dev-repos/printed-wheelbarrow-walker/README.md

# Printed Wheelbarrow Walker

**Site with the assembly video and a 3D part viewer: https://dev-repos.github.io/printed-wheelbarrow-walker/**

A small walking robot that pushes a wheelbarrow, driven by one TT gear motor. Two complete builds from one design:

- **Full 3D print**: 11 parts in [`stl/`](stl/), no supports, every part fits a 180 × 180 mm bed. Settings and fits: [`print.md`](print.md).
- **Full cardboard**: the same parts cut from 3 mm corrugated card. Print [`cardboard/templates.pdf`](cardboard/templates.pdf) at **100 % / actual size** (check the 100 mm bar).

Bought for both: a TT gear motor (double shaft, 3–6 V), a 2×AA battery holder with switch, a 3 mm skewer, a ping-pong ball and a bottle cap. The motor and holder attach without glue (see `print.md`).

| Full 3D print | Full cardboard |
|---|---|
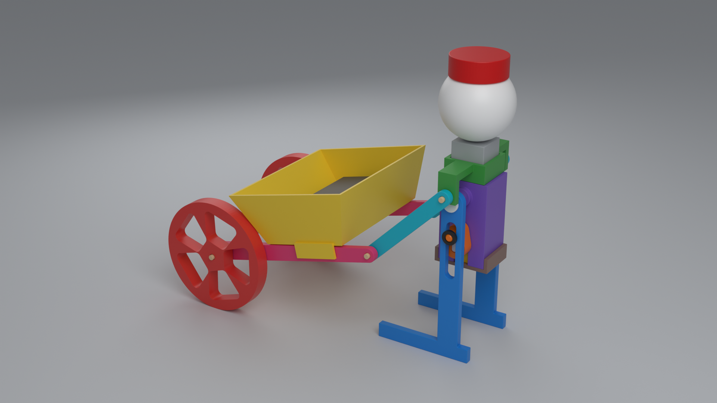
[picture p1: renders/assembled-printed.png]
printed
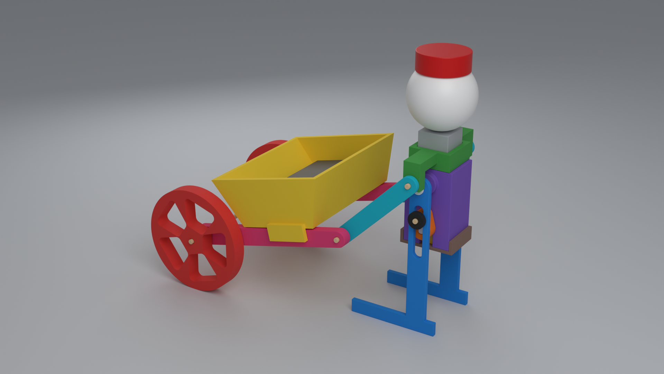
[picture p2: renders/assembled-cardboard.png]
cardboard
|  |  |

Building with kids: a grown-up does knife cuts, hot glue and soldering. Small parts (pegs, caps) are a choking hazard for under-3s.

Mechanism: pendulum legs driven by cranks 180° apart (8 mm crank, hip 26 mm above the shaft). Stride 54.2 mm, foot lift 4.3 mm, checked for clashes at 8 crank angles.

License: MIT.

## Assembly preview

**Assembly video (60 s, with voice-over):** [preview/assembly-sample.mp4](preview/assembly-sample.mp4). A claw gripper pushes the motor into the cradle can first, snaps the clip on, fits the crank, then the leg, hip peg and cap (legs go on before the yoke). Then the battery holder drops into the tray between the ribs, its red and black wires run to the motor tabs, and the switch goes on, so it walks. Each move happens while the voice-over describes it, and every move (and every wire, at every crank angle) is checked so nothing passes through anything else.

Workbench renders of the first build steps (lift → align → fit → check). A two-jaw claw holds each part at the point where you'd grip it.

| Kit | Motor into cradle | Crank onto shaft | Hang a leg |
|---|---|---|---|
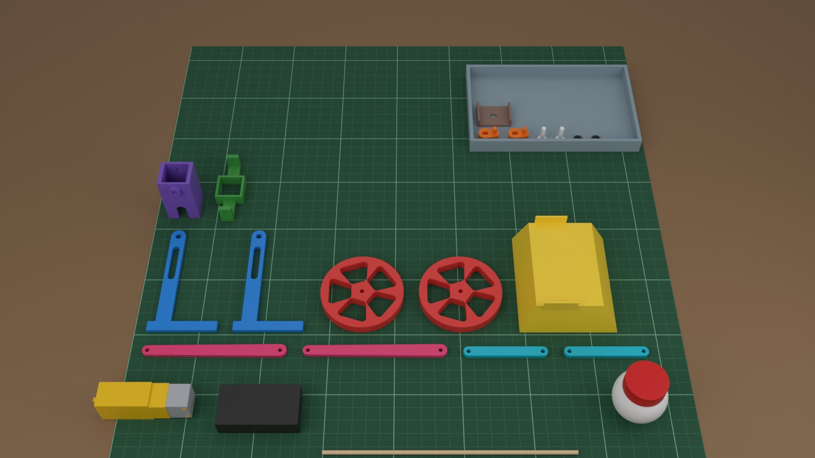
[picture p3: preview/01-kit.jpg]
kit
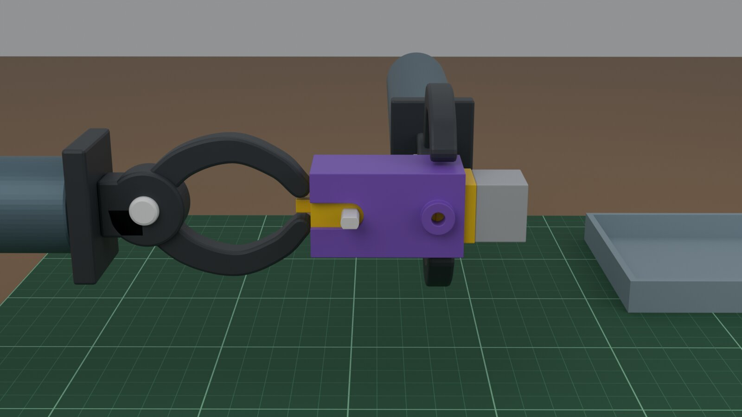
[picture p4: preview/02-motor-3-seated.jpg]
motor
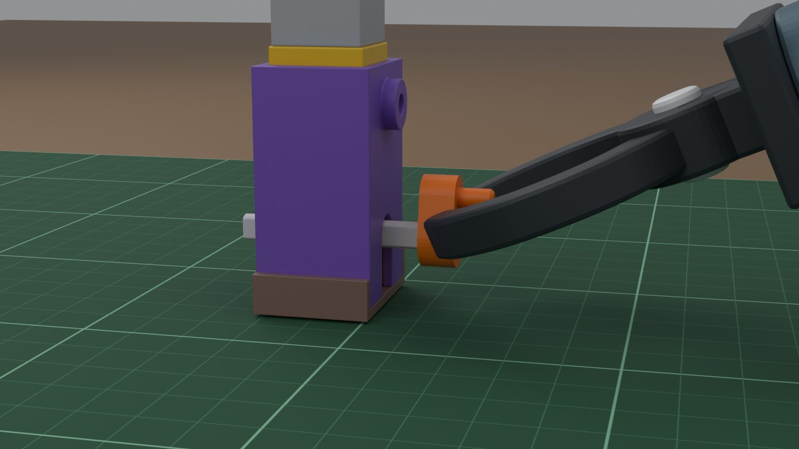
[picture p5: preview/03-crank-2-push.jpg]
crank
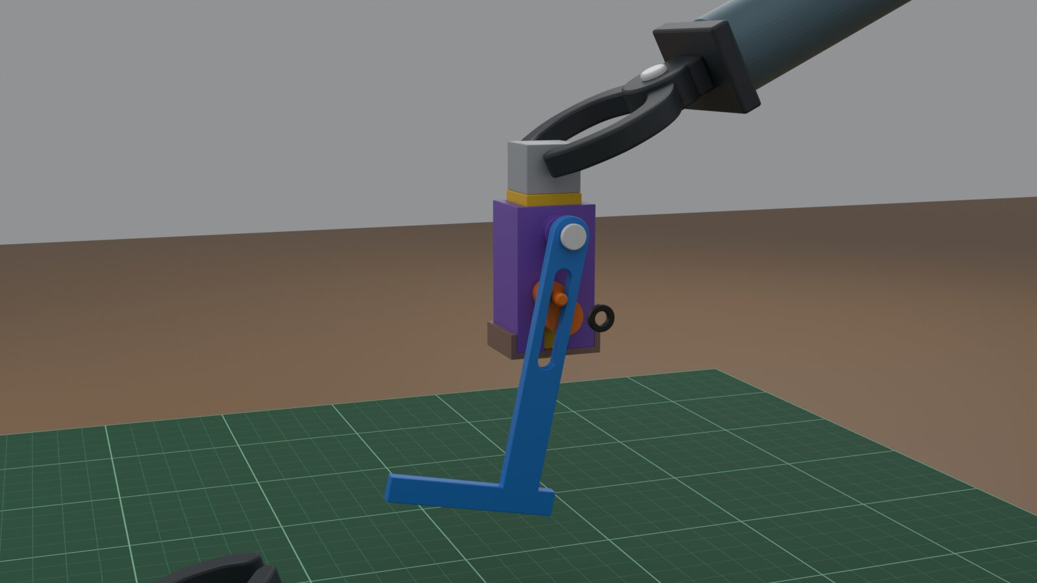
[picture p6: preview/04-leg-3-peg.jpg]
leg
|  |  |  |  |

| Battery holder in the tray | Wires to the motor tabs | Switch on |
|---|---|---|
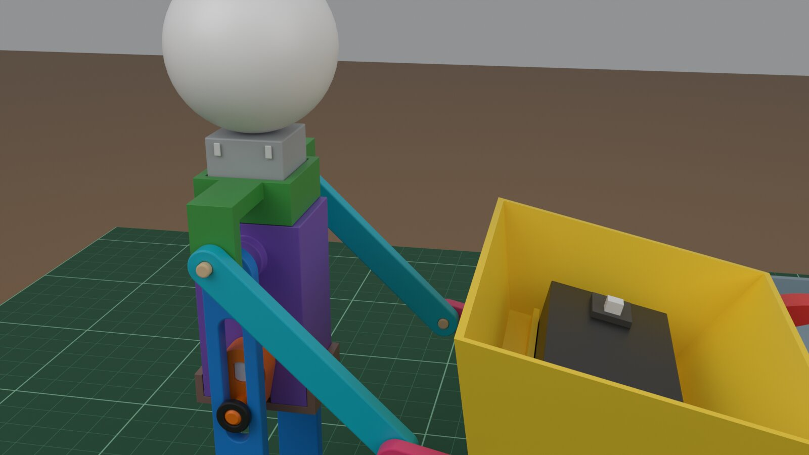
[picture p7: preview/05-power-2-holder.jpg]
holder
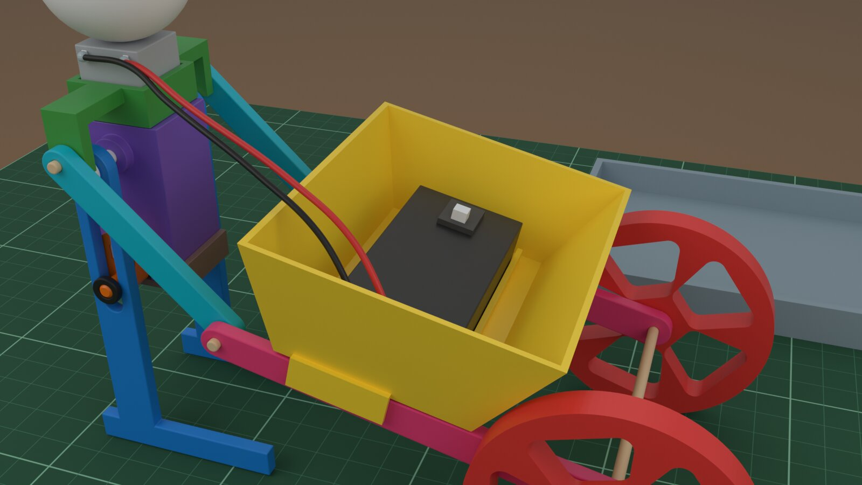
[picture p8: preview/05-power-3-wires.jpg]
wires
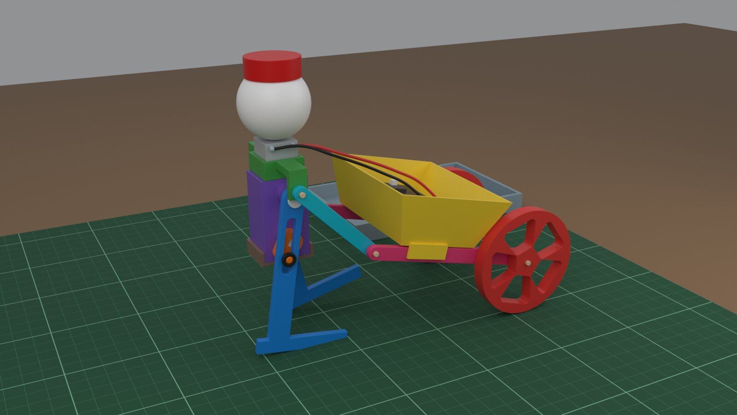
[picture p9: preview/05-power-4-on.jpg]
on
|  |  |  |

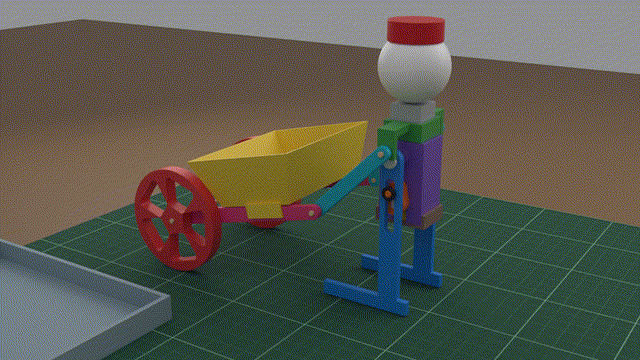
[picture p10: preview/walk.gif]
walking
