dev-repos/printed-wheelbarrow-walker/cardboard/sheet-1.png

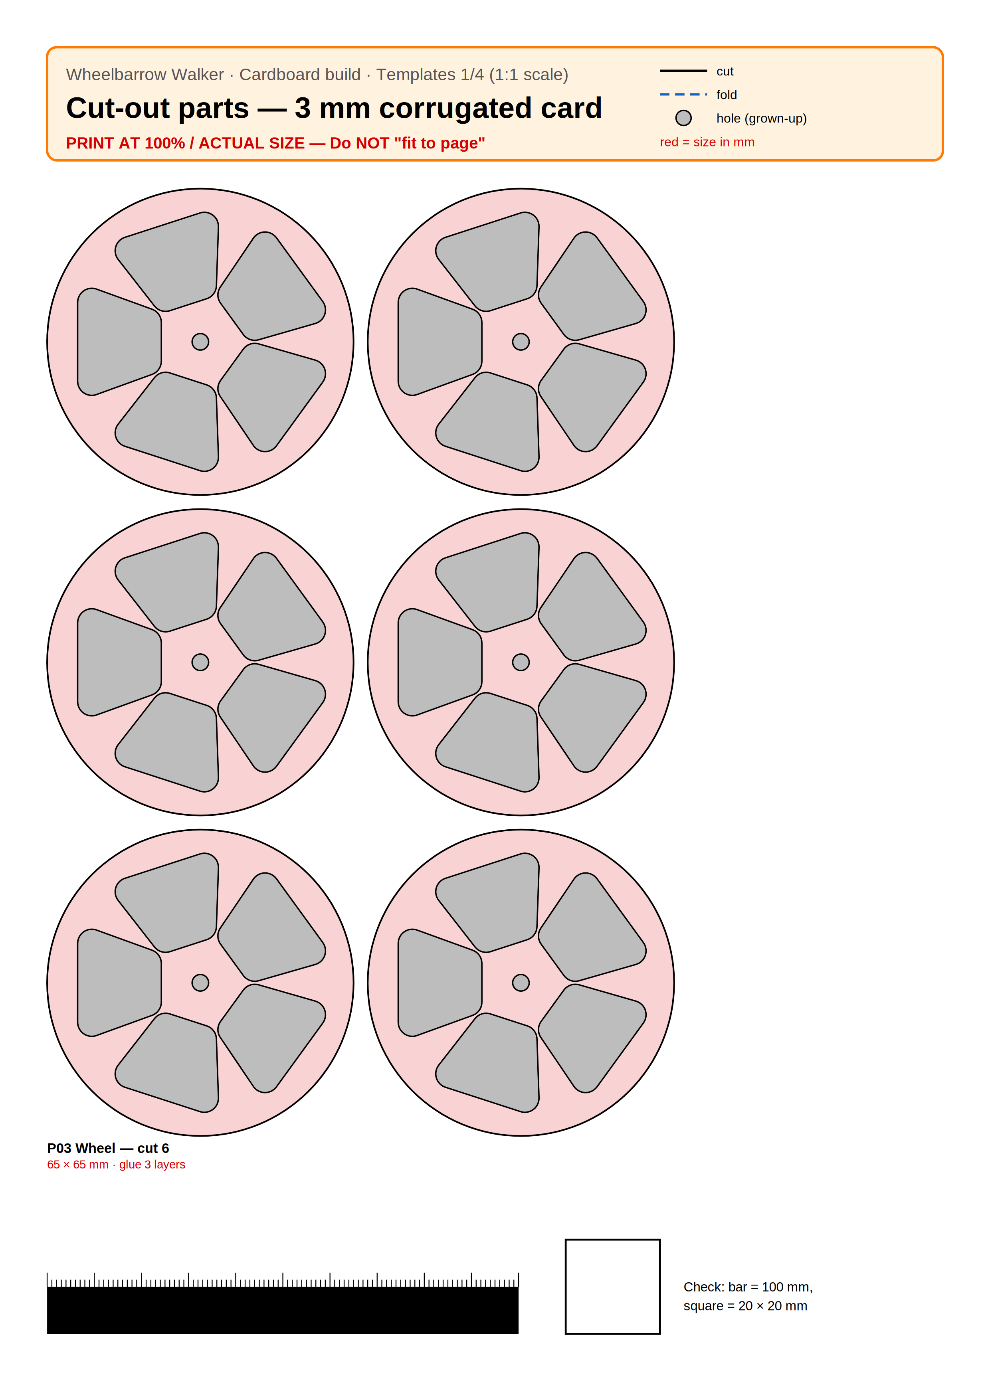
cardboard/sheet-1.png
