dev-repos/printed-wheelbarrow-walker/cardboard/sheet-2.png

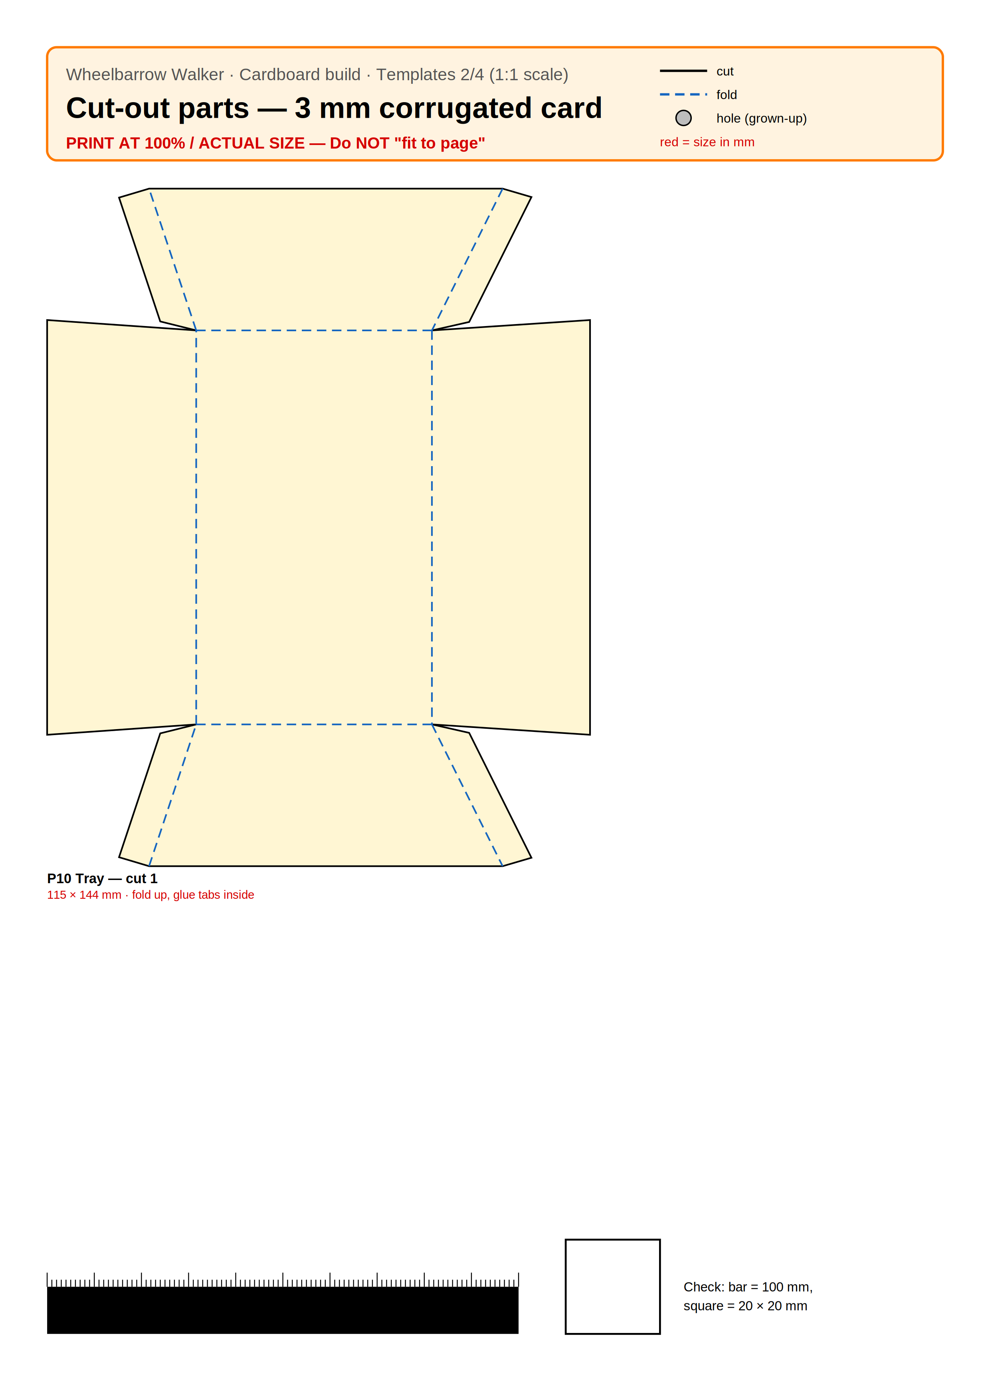
cardboard/sheet-2.png
