dev-repos/printed-wheelbarrow-walker/cardboard/sheet-3.png

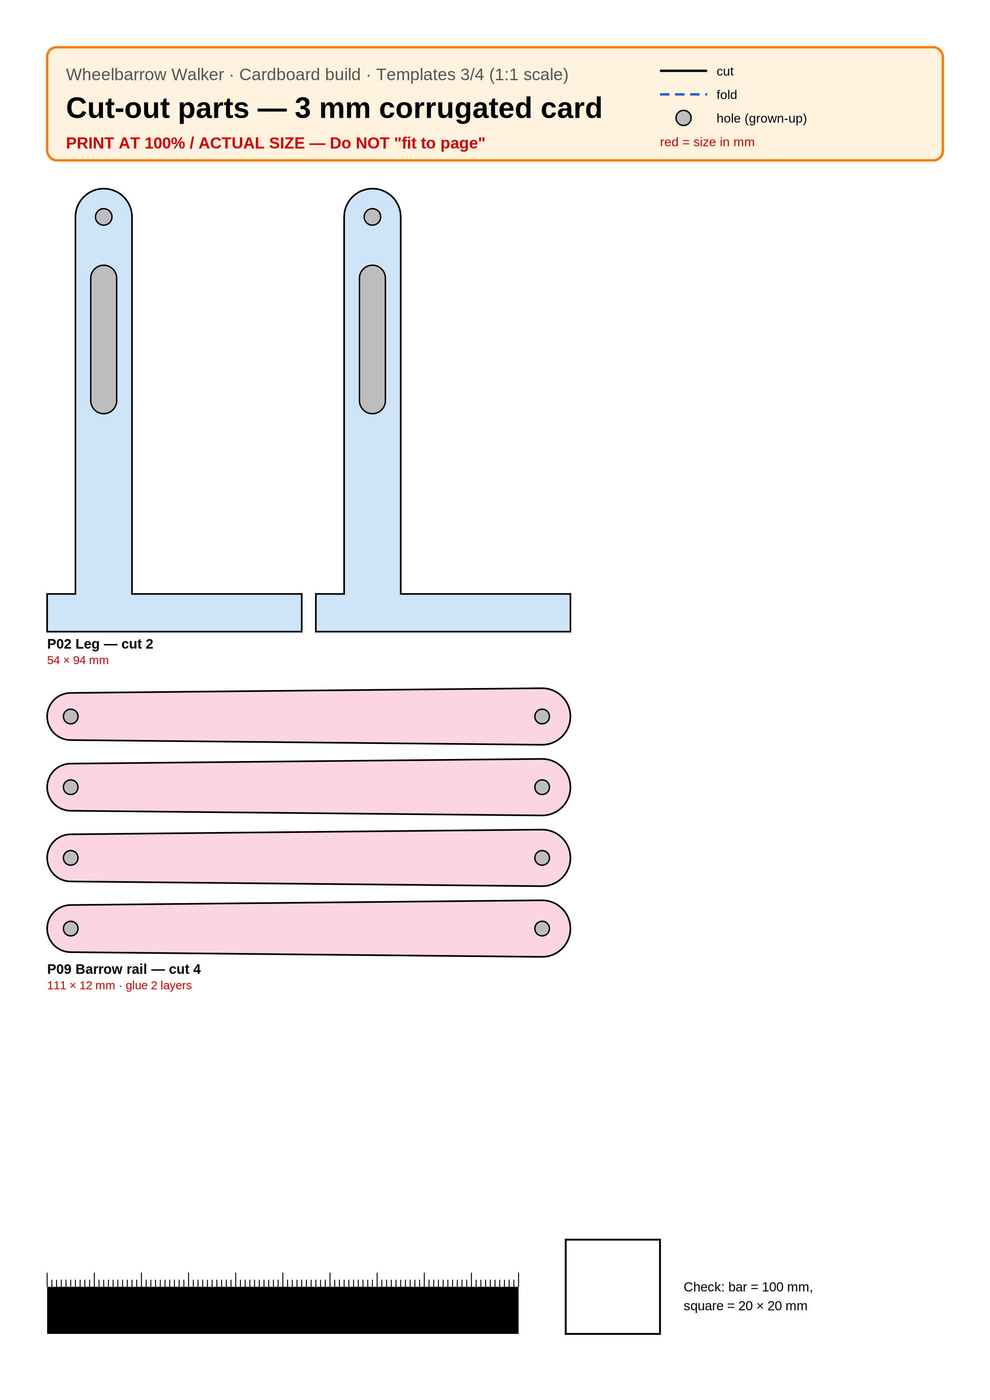
cardboard/sheet-3.png
