dev-repos/printed-wheelbarrow-walker/cardboard/sheet-4.png

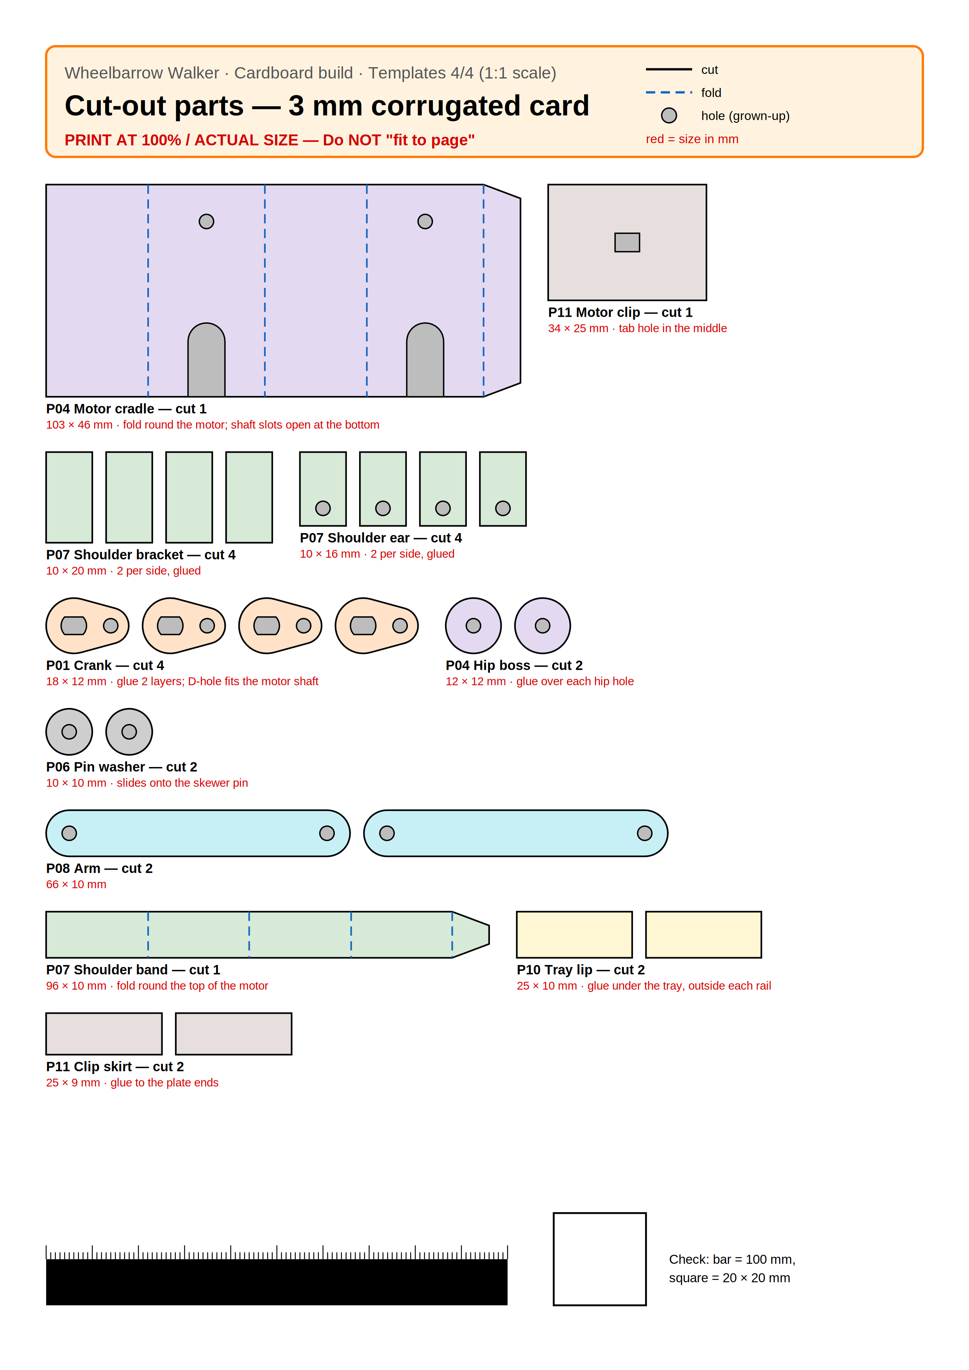
cardboard/sheet-4.png
