dev-repos/printed-wheelbarrow-walker/preview/02-motor-1-align.jpg

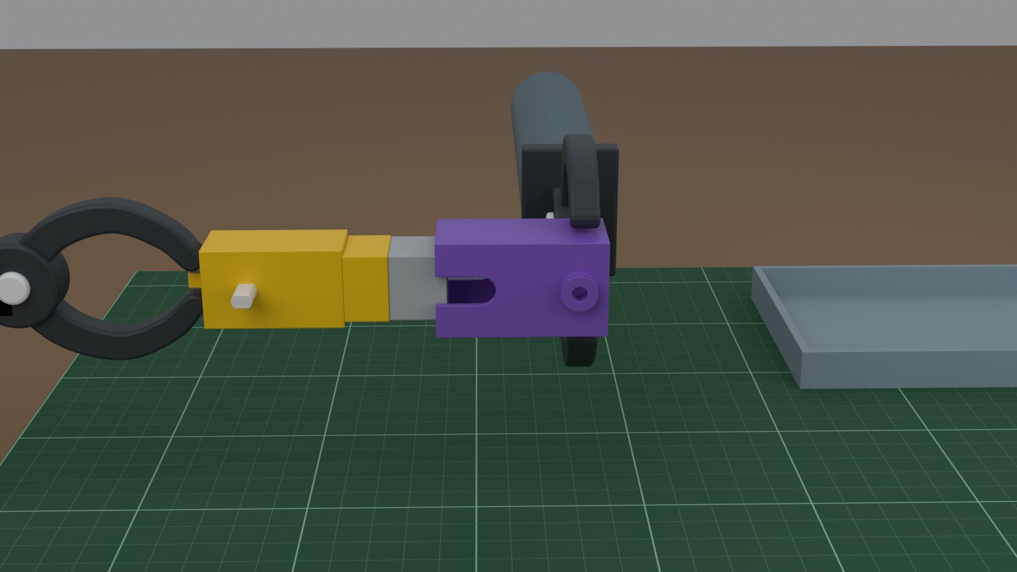
preview/02-motor-1-align.jpg
