dev-repos/printed-wheelbarrow-walker/preview/02-motor-2-slide.jpg

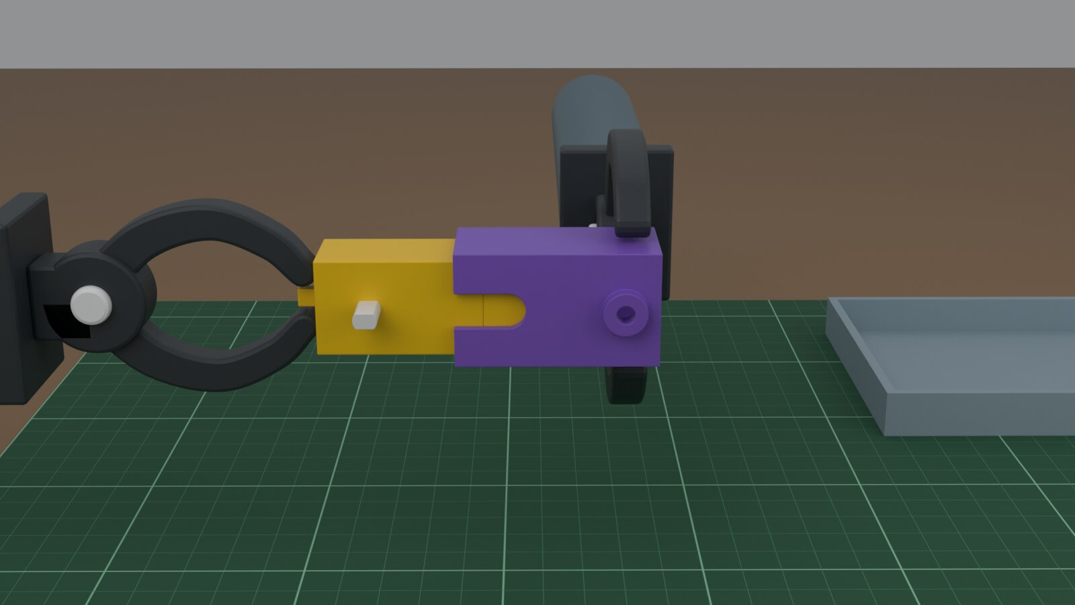
preview/02-motor-2-slide.jpg
