dev-repos/printed-wheelbarrow-walker/preview/02-motor-4-clip.jpg

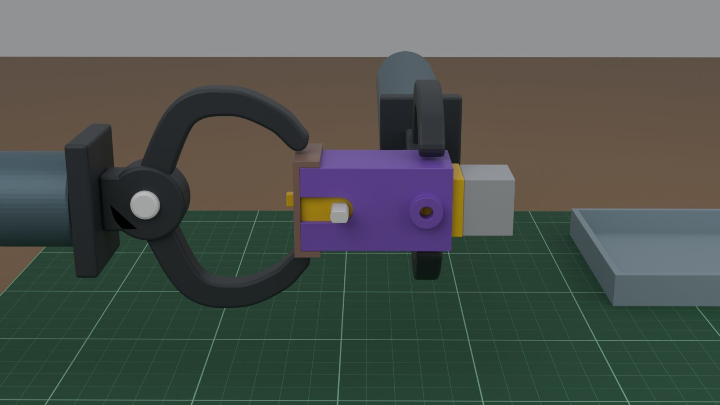
preview/02-motor-4-clip.jpg
