dev-repos/printed-wheelbarrow-walker/preview/03-crank-1-align.jpg

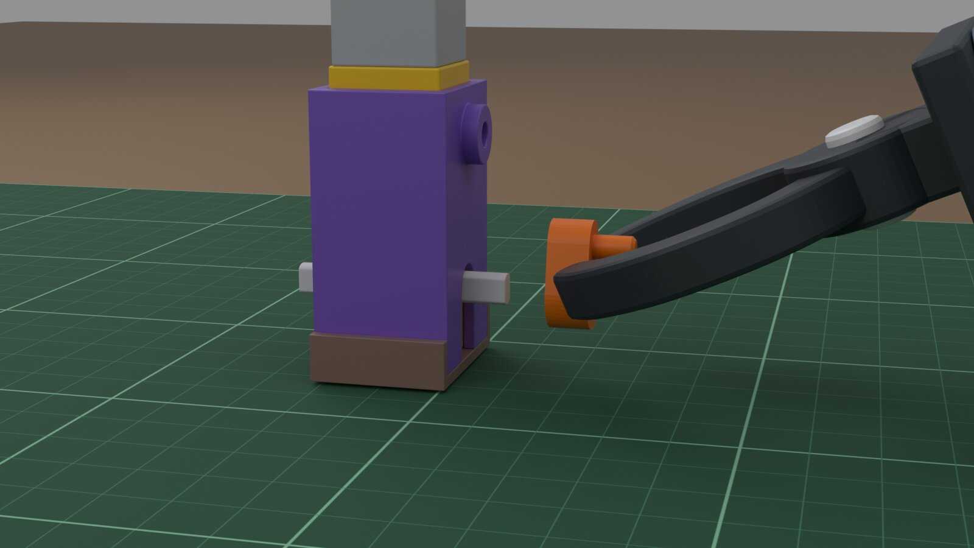
preview/03-crank-1-align.jpg
