dev-repos/printed-wheelbarrow-walker/preview/03-crank-3-seated.jpg

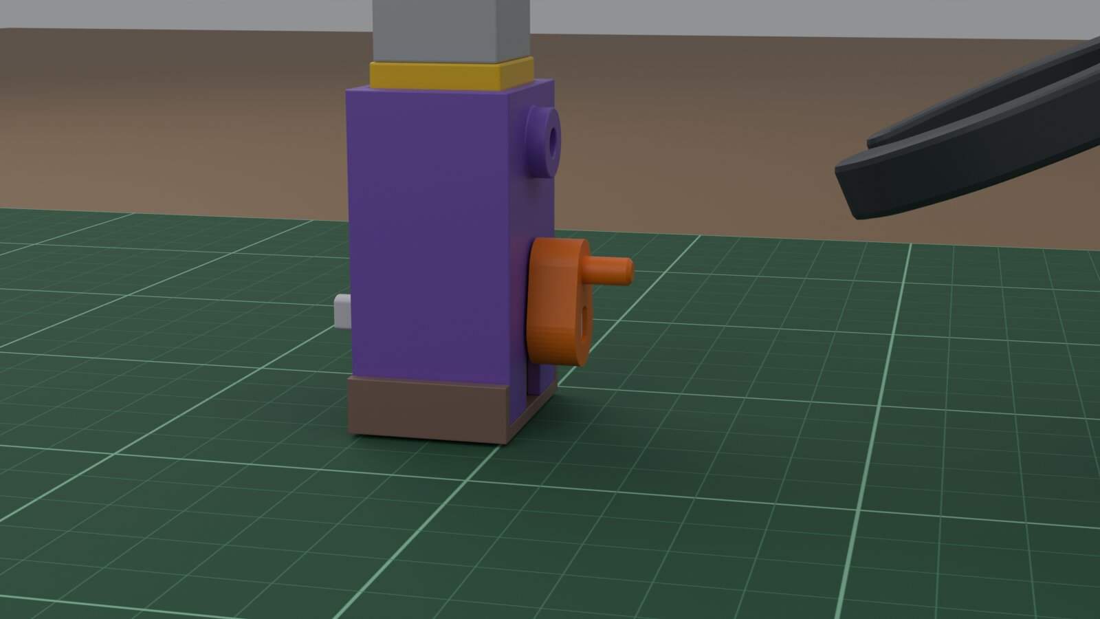
preview/03-crank-3-seated.jpg
