dev-repos/printed-wheelbarrow-walker/preview/04-leg-1-align.jpg

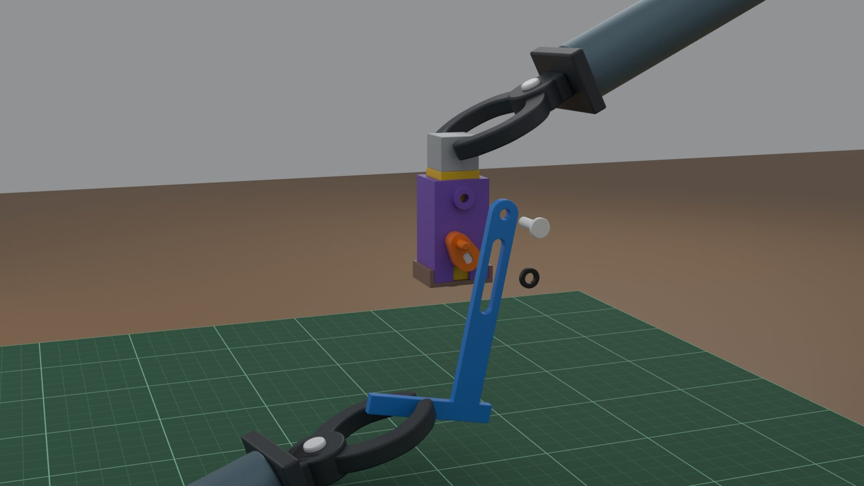
preview/04-leg-1-align.jpg
