dev-repos/printed-wheelbarrow-walker/preview/04-leg-2-on-pin.jpg

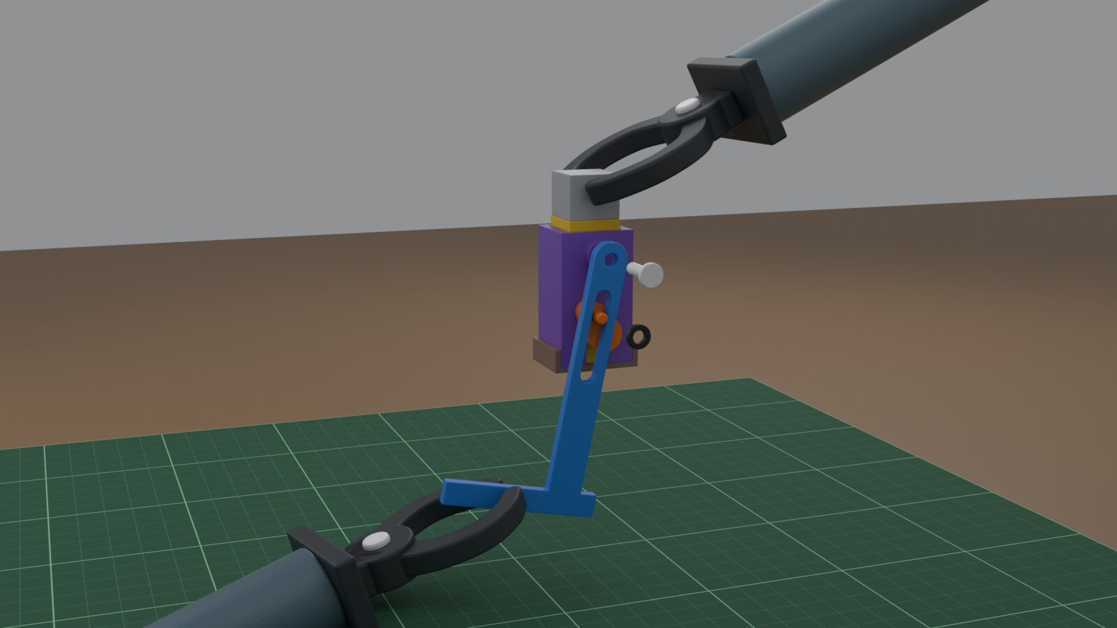
preview/04-leg-2-on-pin.jpg
