dev-repos/printed-wheelbarrow-walker/preview/04-leg-4-cap.jpg

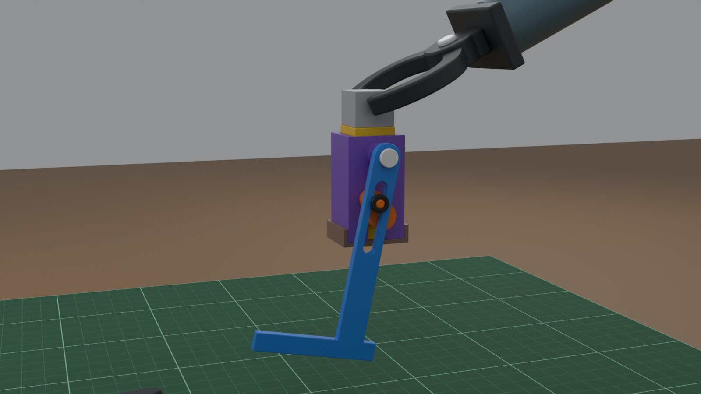
preview/04-leg-4-cap.jpg
