dev-repos/printed-wheelbarrow-walker/preview/05-power-1-finished.jpg

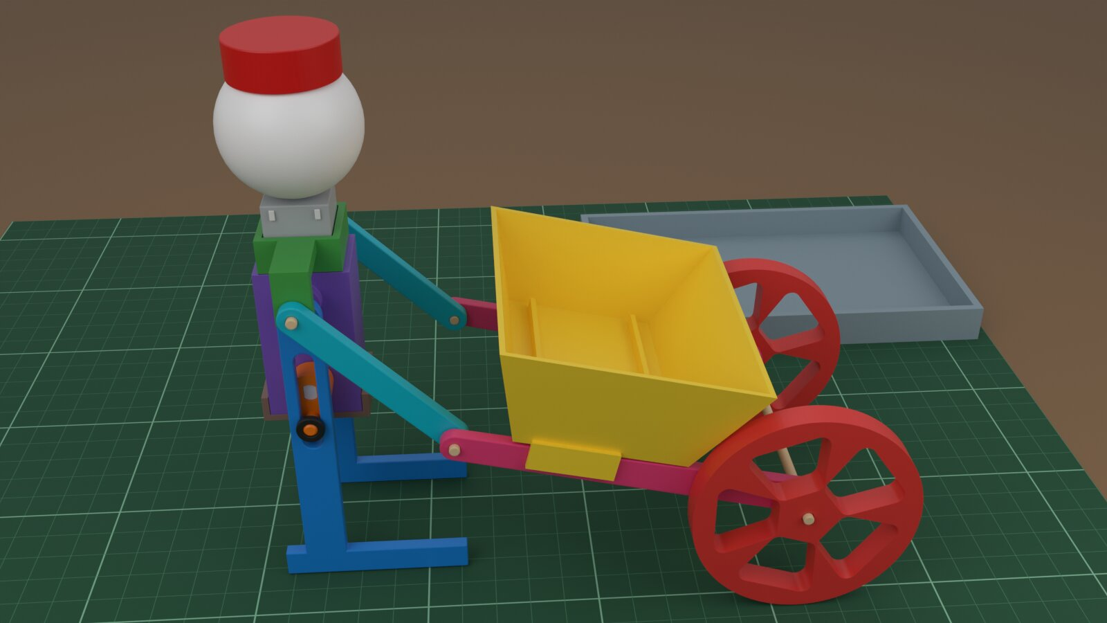
preview/05-power-1-finished.jpg
