dev-repos/printed-wheelbarrow-walker/stl/P06_pin_cap.stl

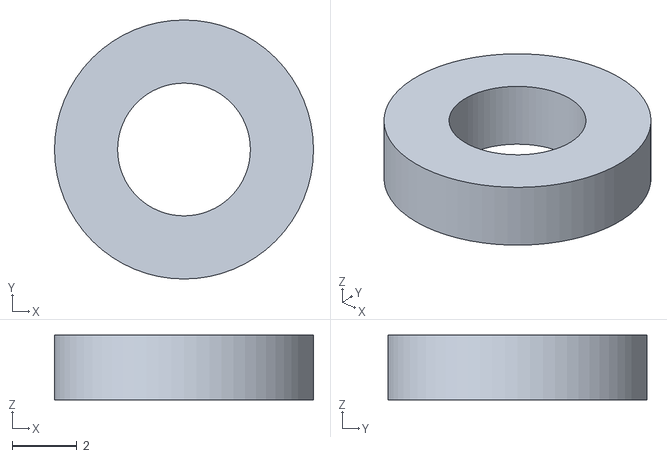
[picture p24: CAD file, 2026-10-27]
stl/P06_pin_cap.stl
8.00 x 8.00 x 2.00
