dev-repos/printed-wheelbarrow-walker/stl/P02_leg.stl

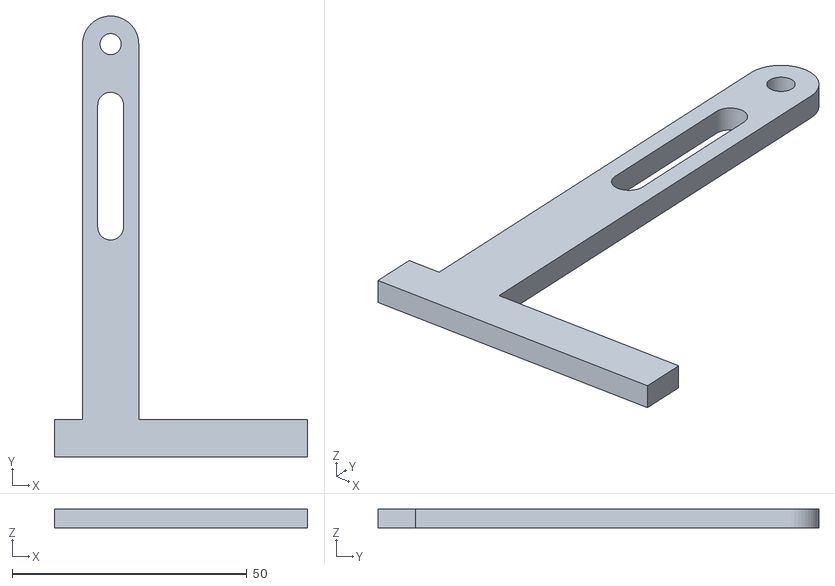
[picture p25: CAD file, 2026-10-27]
stl/P02_leg.stl
54.0 x 94.0 x 4.00
