dev-repos/printed-wheelbarrow-walker/stl/P10_tray.stl

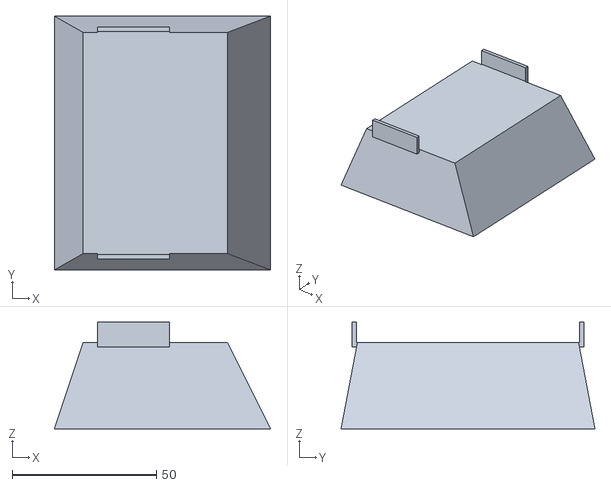
[picture p26: CAD file, 2026-10-27]
stl/P10_tray.stl
75.0 x 88.0 x 37.0
