dev-repos/printed-wheelbarrow-walker/stl/P11_motor_clip.stl

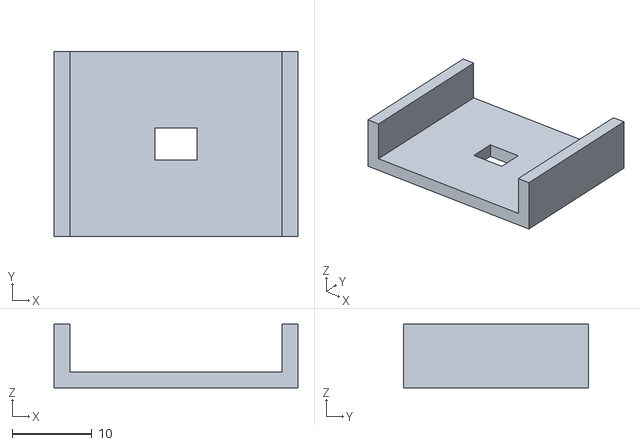
[picture p27: CAD file, 2026-10-27]
stl/P11_motor_clip.stl
30.5 x 23.1 x 8.00
