dev-repos/printed-wheelbarrow-walker/stl/P04_cradle.stl

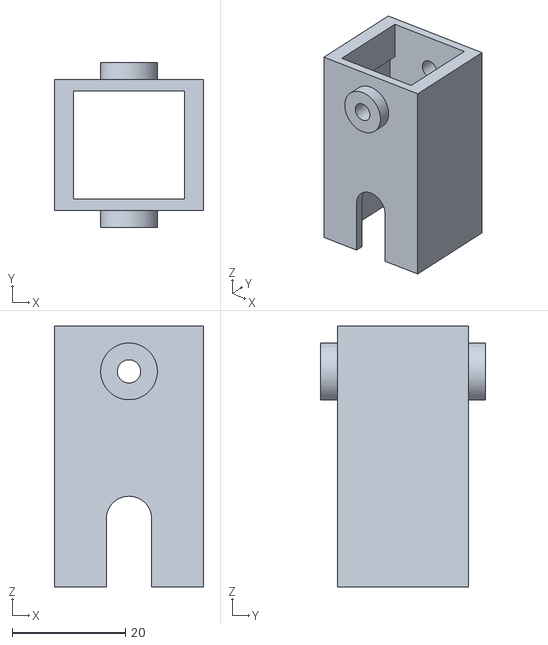
[picture p28: CAD file, 2026-10-27]
stl/P04_cradle.stl
26.3 x 29.0 x 46.0
