dev-repos/printed-wheelbarrow-walker/stl/P09_rail.stl

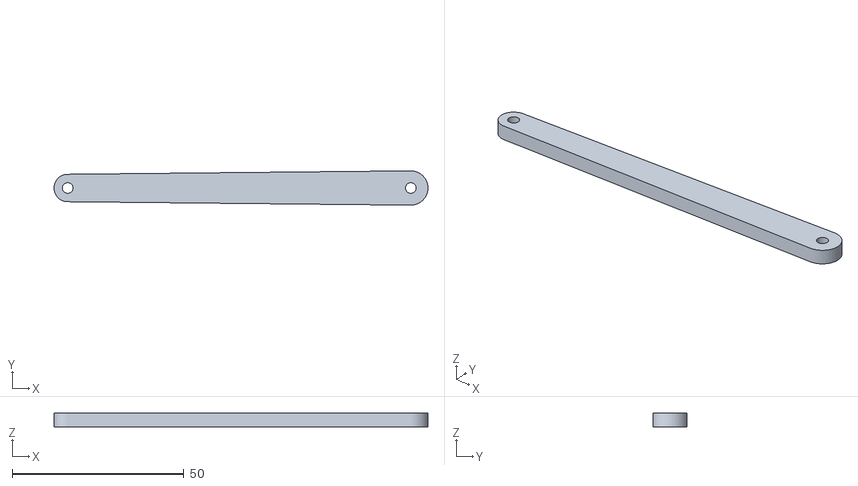
[picture p29: CAD file, 2026-10-27]
stl/P09_rail.stl
109.0 x 10.0 x 4.00
