dev-repos/printed-wheelbarrow-walker/stl/P05_hip_peg.stl

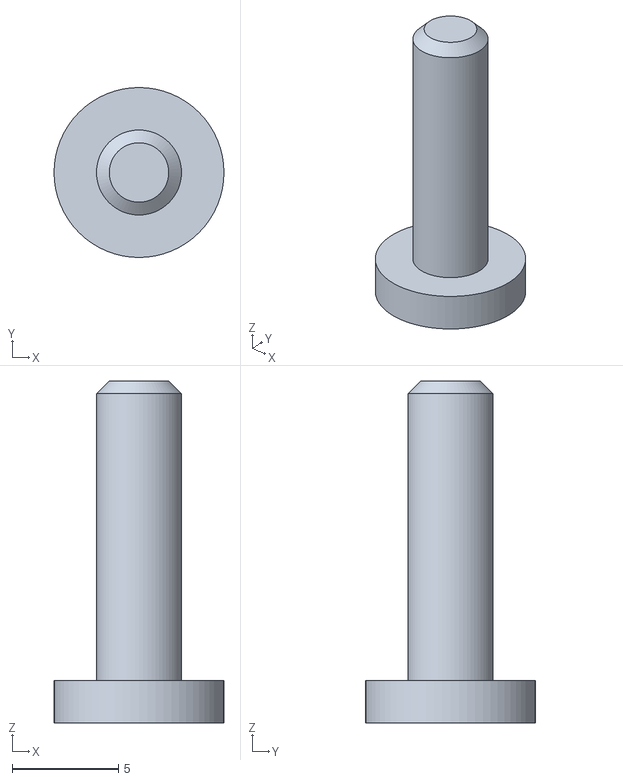
[picture p30: CAD file, 2026-10-27]
stl/P05_hip_peg.stl
8.00 x 8.00 x 16.1
