dev-repos/printed-wheelbarrow-walker/stl/P03_wheel.stl

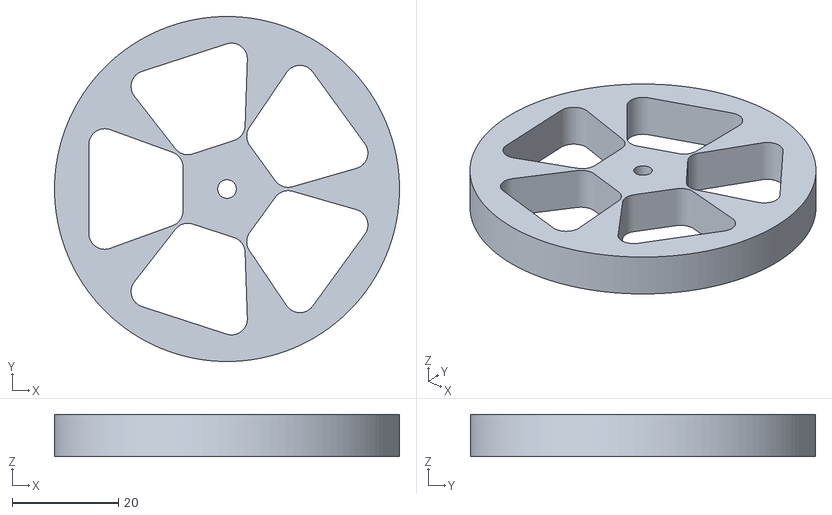
[picture p31: CAD file, 2026-10-27]
stl/P03_wheel.stl
65.0 x 65.0 x 8.00
