dev-repos/printed-wheelbarrow-walker/stl/P01_crank.stl

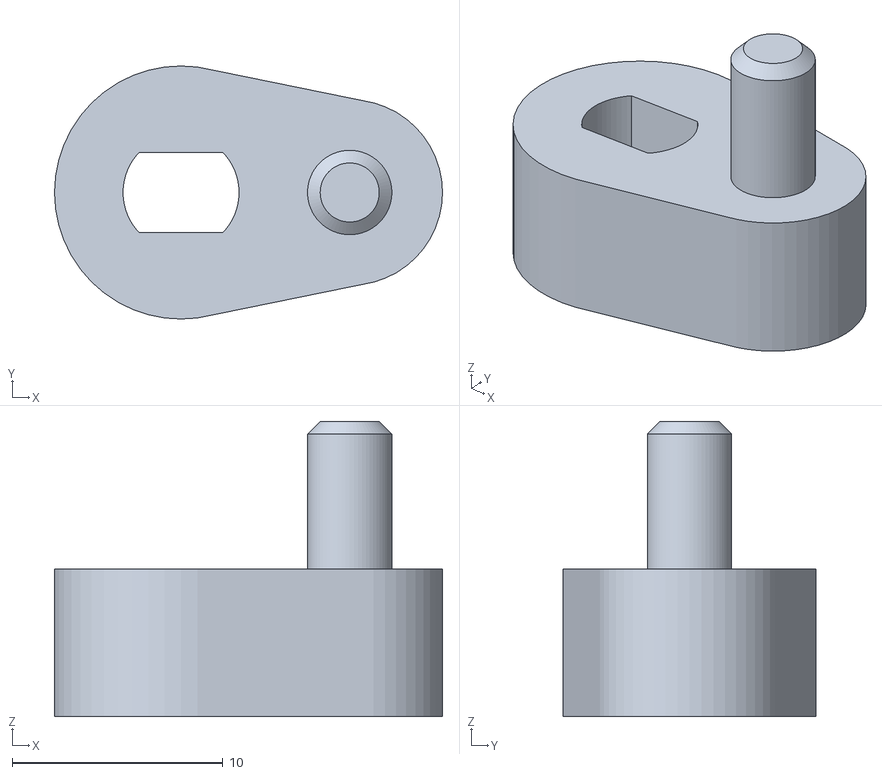
[picture p32: CAD file, 2026-10-27]
stl/P01_crank.stl
18.4 x 12.0 x 14.0
