dev-repos/printed-wheelbarrow-walker/stl/P07_yoke.stl

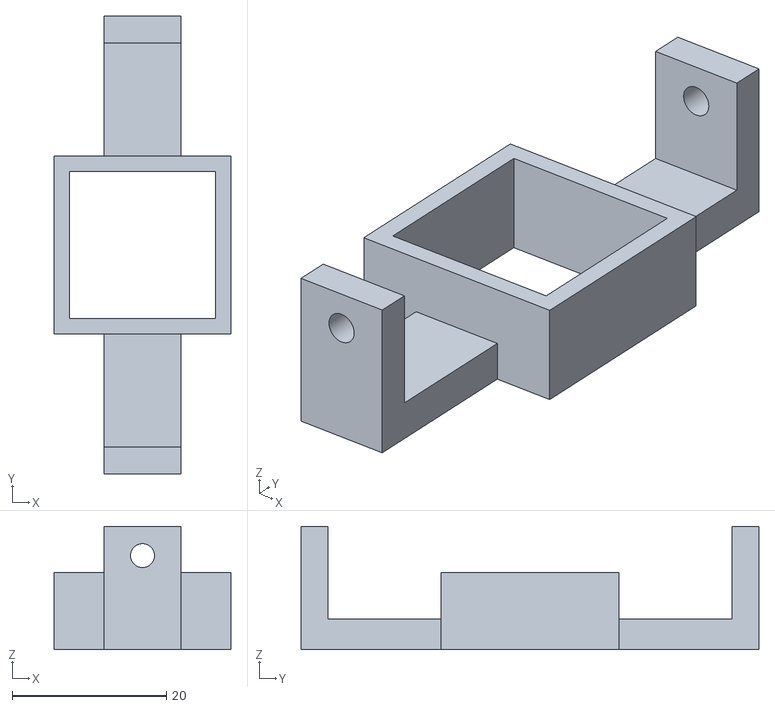
[picture p33: CAD file, 2026-10-27]
stl/P07_yoke.stl
22.9 x 59.4 x 16.0
