dev-repos/printed-wheelbarrow-walker/stl/P08_arm.stl

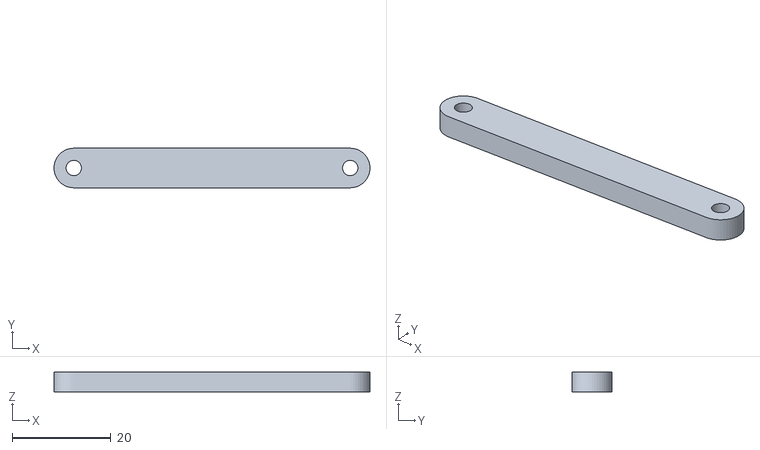
[picture p34: CAD file, 2026-10-27]
stl/P08_arm.stl
63.9 x 8.00 x 4.00
