dev-repos/printed-wheelbarrow-walker/cardboard/templates.pdf

## Wheelbarrow Walker · Cardboard build · Templates 1/4 (1:1 scale)

# Cut-out parts — 3 mm corrugated card

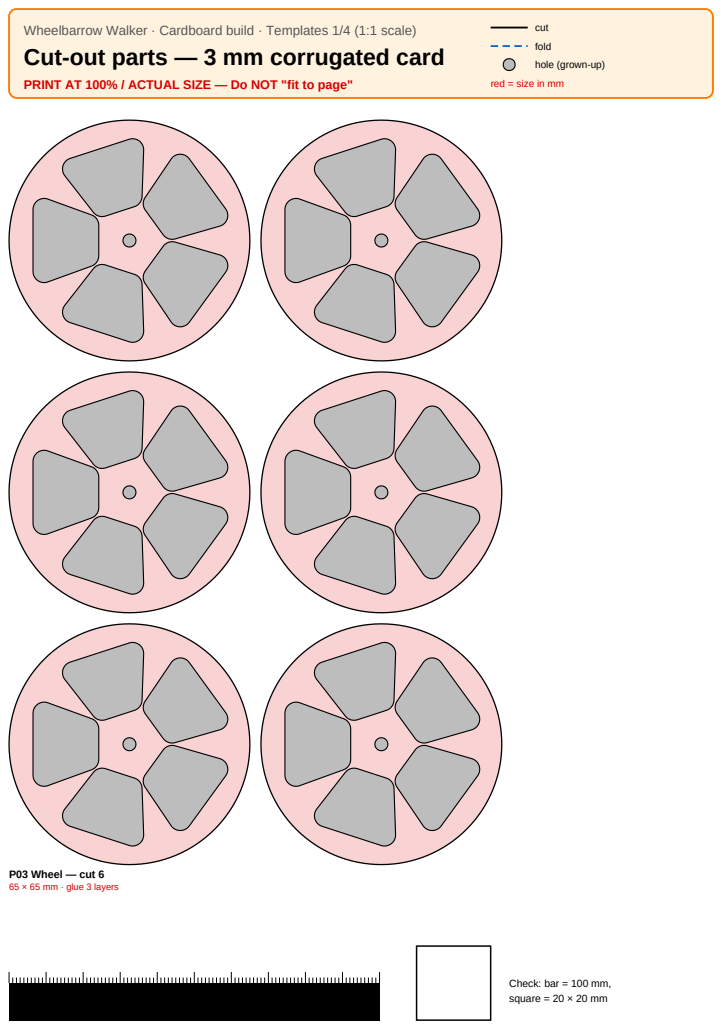
[picture p35: page 1]

cut
fold
hole (grown-up)

PRINT AT 100% / ACTUAL SIZE — Do NOT "fit to page"

red = size in mm

P03 Wheel — cut 6
65 × 65 mm · glue 3 layers

Check: bar = 100 mm,
square = 20 × 20 mm

## Wheelbarrow Walker · Cardboard build · Templates 2/4 (1:1 scale)

## PRINT AT 100% / ACTUAL SIZE — Do NOT "fit to page"

red = size in mm

P10 Tray — cut 1
115 × 144 mm · fold up, glue tabs inside

## Wheelbarrow Walker · Cardboard build · Templates 3/4 (1:1 scale)

## PRINT AT 100% / ACTUAL SIZE — Do NOT "fit to page"

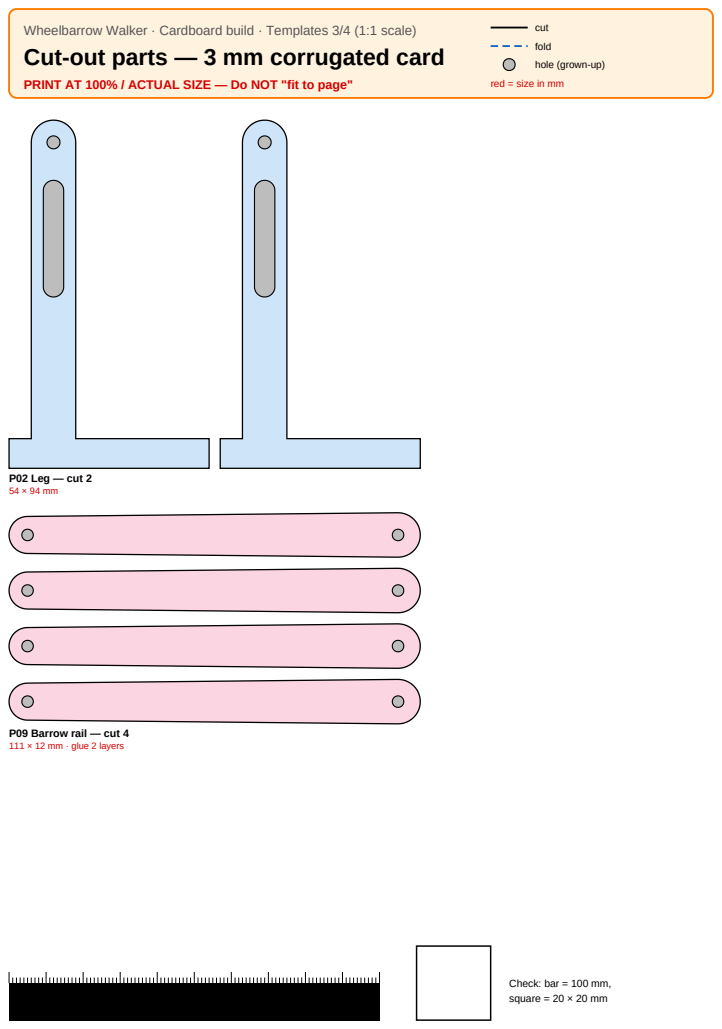
[picture p36: page 3]
P02 Leg — cut 2 54 × 94 mm

red = size in mm

P09 Barrow rail — cut 4
111 × 12 mm · glue 2 layers

## Wheelbarrow Walker · Cardboard build · Templates 4/4 (1:1 scale)

## PRINT AT 100% / ACTUAL SIZE — Do NOT "fit to page"

red = size in mm

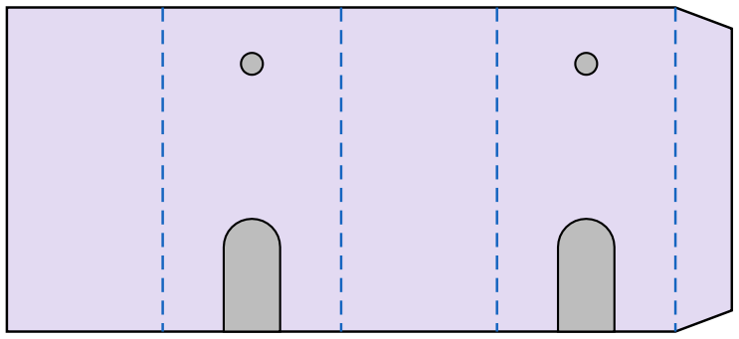
[picture p37: figure]

P04 Motor cradle — cut 1
103 × 46 mm · fold round the motor; shaft slots open at the bottom

P11 Motor clip — cut 1
34 × 25 mm · tab hole in the middle

P07 Shoulder bracket — cut 4 10 × 20 mm · 2 per side, glued

P07 Shoulder ear — cut 4
10 × 16 mm · 2 per side, glued

P01 Crank — cut 4
18 × 12 mm · glue 2 layers; D-hole fits the motor shaft

P04 Hip boss — cut 2
12 × 12 mm · glue over each hip hole

P06 Pin washer — cut 2
10 × 10 mm · slides onto the skewer pin

P08 Arm — cut 2
66 × 10 mm

P07 Shoulder band — cut 1
96 × 10 mm · fold round the top of the motor

P10 Tray lip — cut 2
25 × 10 mm · glue under the tray, outside each rail

P11 Clip skirt — cut 2
25 × 9 mm · glue to the plate ends
