dev-repos/printed-wheelbarrow-walker/(commit log)

2026-10-27 Wheelbarrow walker: STLs, print sheet, cardboard templates, assembly preview
    [P01_crank.stl, P02_leg.stl, P03_wheel.stl, P04_cradle.stl, P05_hip_peg.stl, P06_pin_cap.stl, P07_yoke.stl, P08_arm.stl]
2026-10-27 Add 20 s animated assembly video sample
2026-10-28 Fix assembly sample: motor goes into the cradle from the open end, legs before the yoke
2026-10-28 Preview stills: motor goes into the cradle from the open end, legs before the yoke
2026-10-28 Assembly video with voice-over and claw gripper; stills re-rendered
2026-10-28 Assembly video: battery holder, wires and switch step; power stills
